Cale-star/shelter-beacon-demo/assets/img/07_wiring_inside.webp

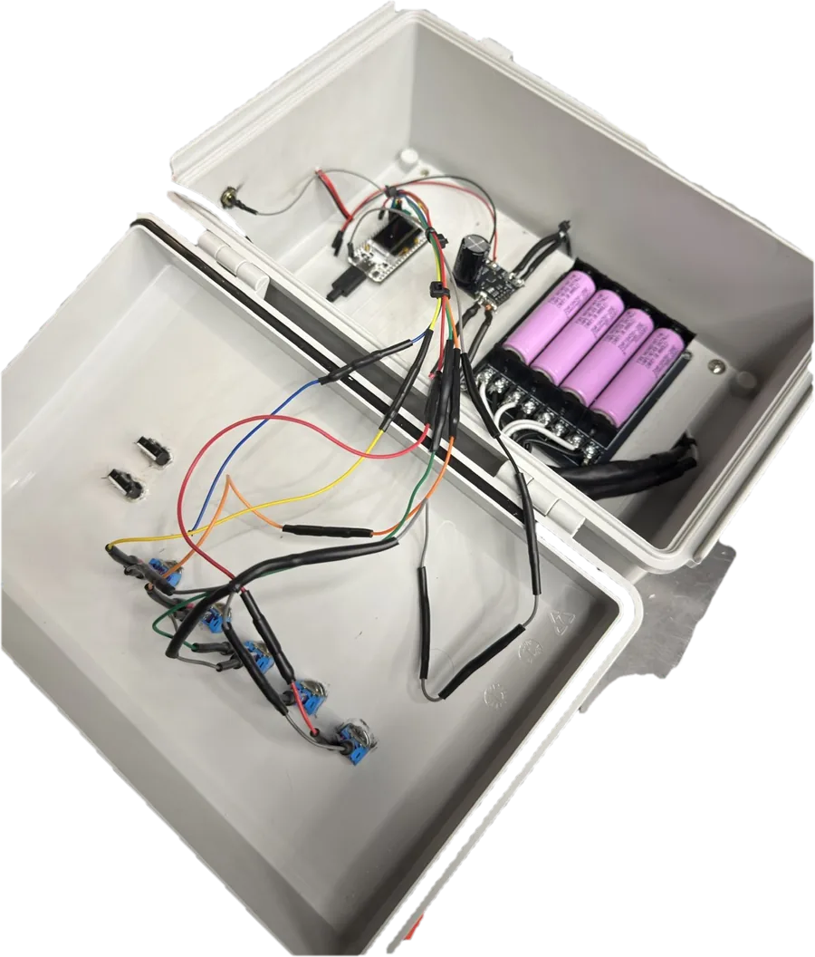
assets/img/07_wiring_inside.webp
