Cale-star/shelter-beacon-demo/assets/img/05_plate_in_box.webp

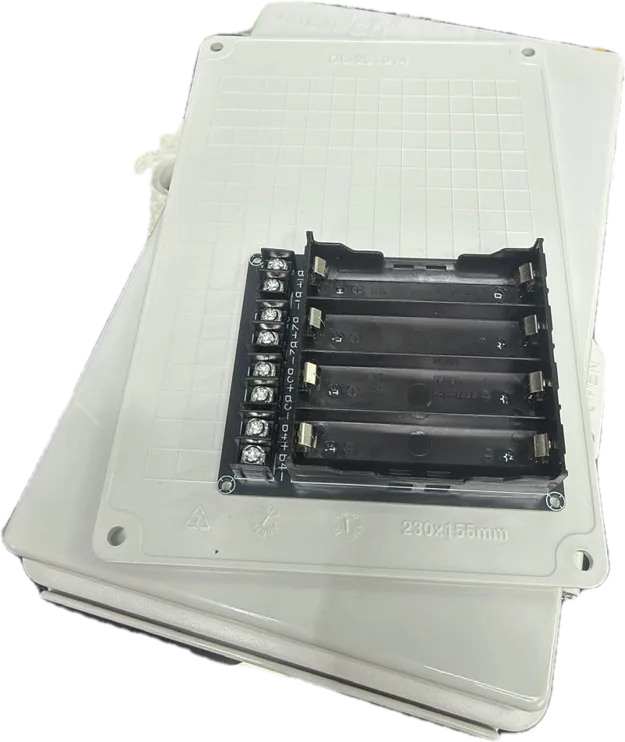
assets/img/05_plate_in_box.webp
