Cale-star/shelter-beacon-demo/assets/files/Shelter_Beacon_Lid_Template_and_Overlay.pdf

Shelter Beacon lid: DRILL TEMPLATE (page 1/2). Print on US Legal at 100% / Actual size, check the 100 mm ruler. Trim on the outline, tape to the lid (hinges on the LEFT), center-punch each crosshair, drill. Check the toggle hole size against your old box before drilling.

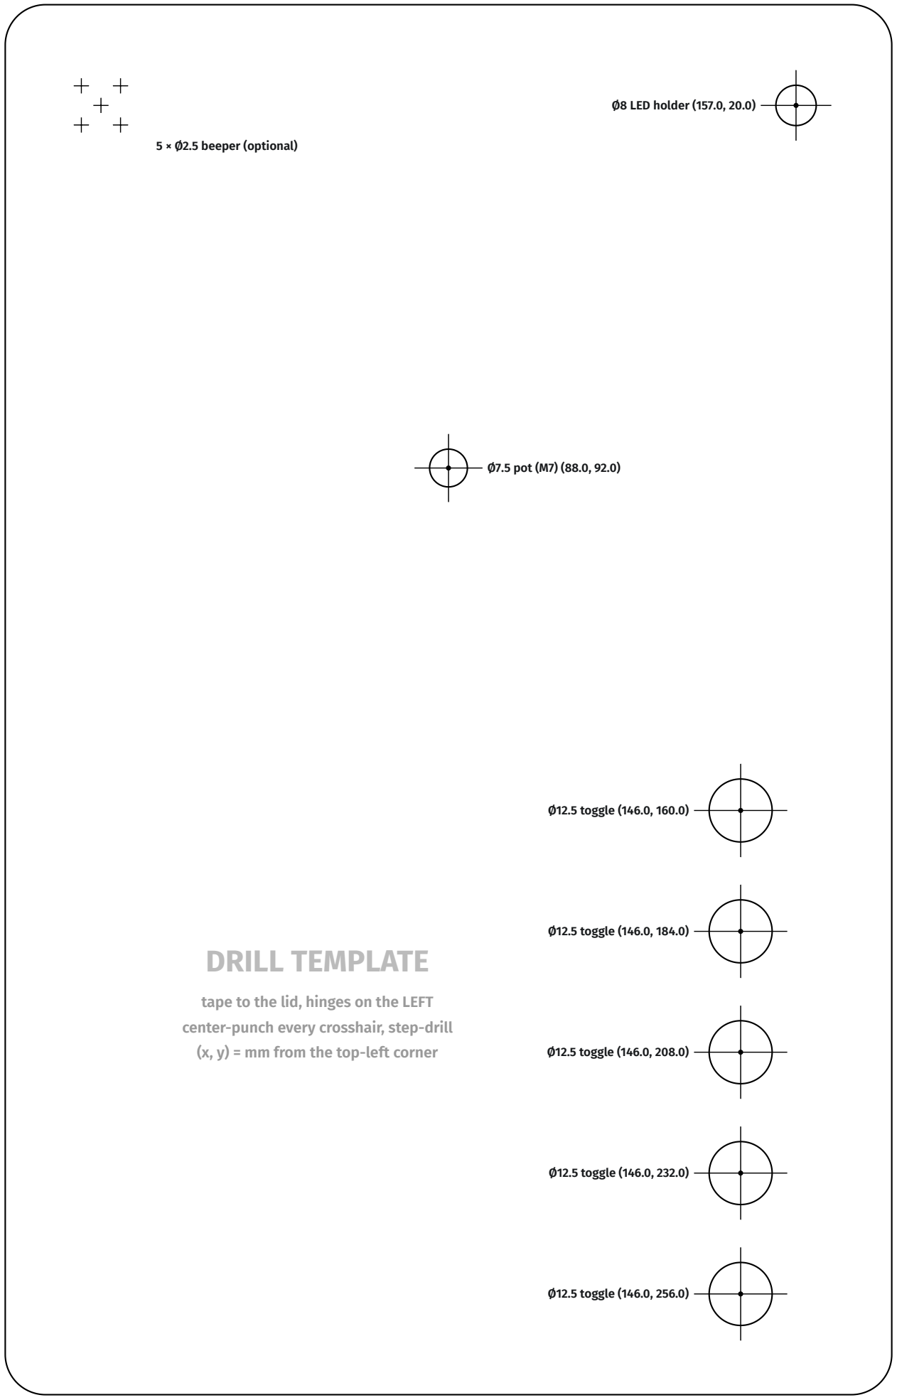
[picture p4: figure]
Ø8 LED holder (157.0, 20.0); Ø7.5 pot (M7) (88.0, 92.0); Ø12.5 toggle (146.0, 160.0); Ø12.5 toggle (146.0, 184.0); Ø12.5 toggle (146.0, 208.0); Ø12.5 toggle (146.0, 232.0); Ø12.5 toggle (146.0, 256.0); 5 × Ø2.5 beeper (optional); DRILL TEMPLATE; tape to the lid, hinges on the LEFT center-punch every crosshair, step-drill (x, y) = mm from the top-left corner

100 mm: measure this to check the print scale

Shelter Beacon lid: OVERLAY (page 2/2). Plain paper = test fit. Printable matte vinyl + matte laminate = the real thing. Cut on the red dashed outline, punch the dashed circles, apply AFTER drilling, then refit the nuts over it.

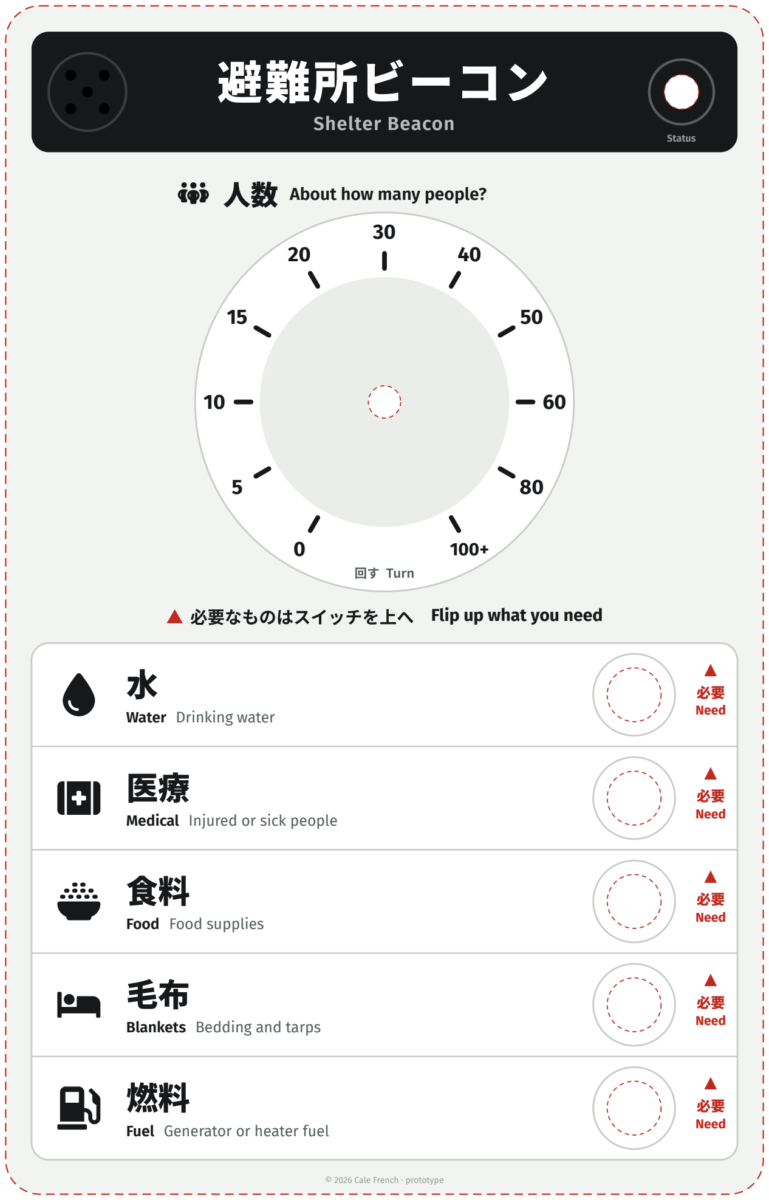
[picture p5: figure]
避難所ビーコン; Shelter Beacon; Status; 人数 About how many people?; 回す Turn; ▲ 必要なものはスイッチを上へ Flip up what you need; Water Drinking water; 必要 Need; Medical Injured or sick people; Food Food supplies; Blankets Bedding and tarps; Fuel Generator or heater fuel; © 2026 Cale French · prototype

100 mm: measure this to check the print scale
