Cale-star/shelter-beacon-demo/assets/img/01_lid_switch_layout.webp

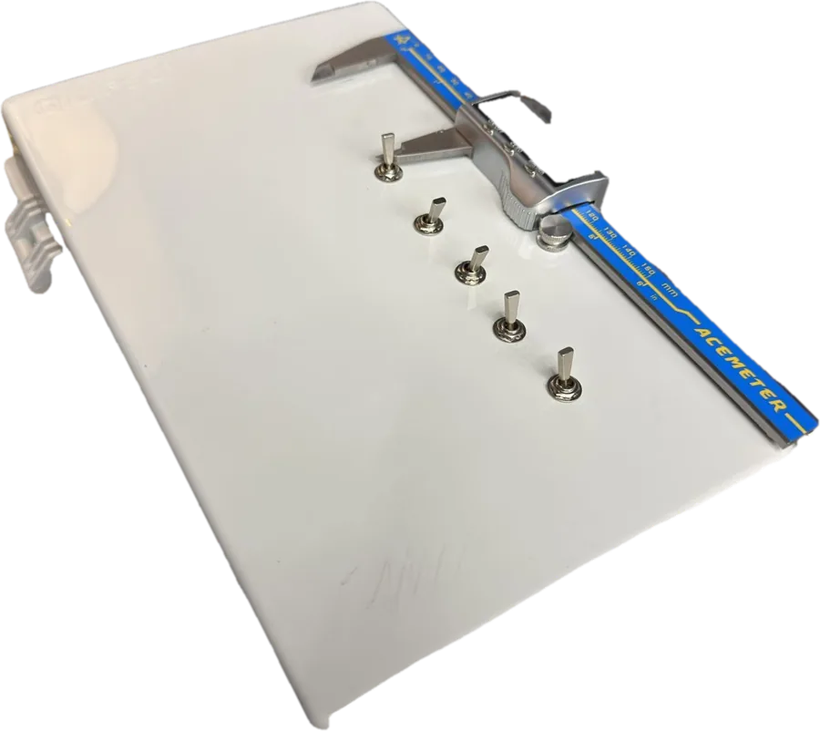
assets/img/01_lid_switch_layout.webp
