Cale-star/shelter-beacon-demo/assets/img/06_battery_mounted.webp

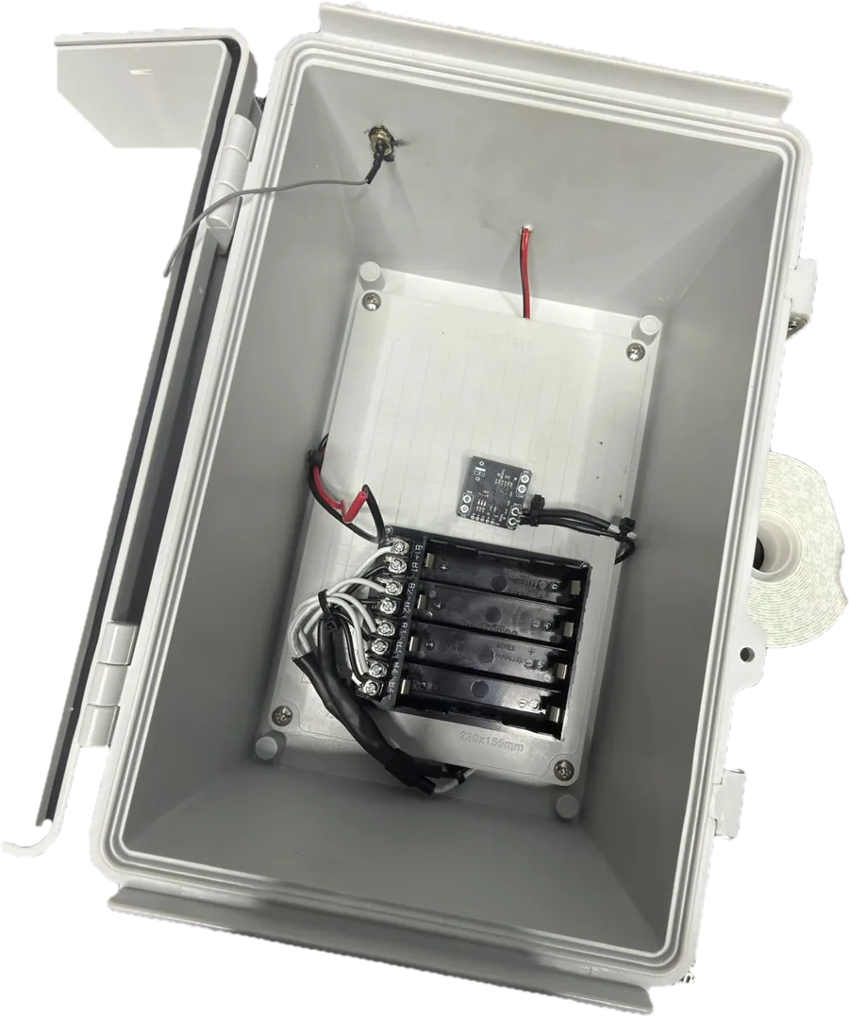
assets/img/06_battery_mounted.webp
