Cale-star/shelter-beacon-demo/assets/img/dashboard_2_needs_water.jpg

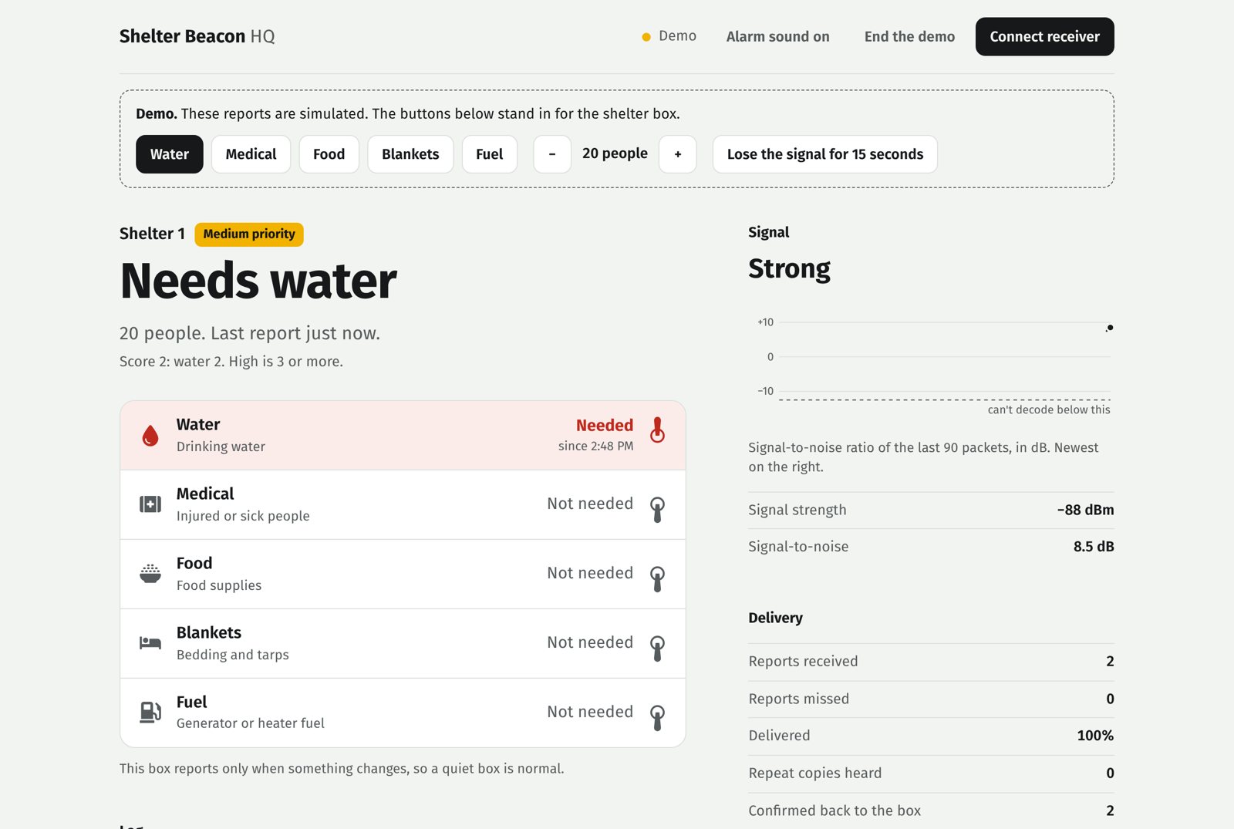
assets/img/dashboard_2_needs_water.jpg
