Cale-star/shelter-beacon-demo/assets/img/dashboard_3_high_priority_alarm.jpg

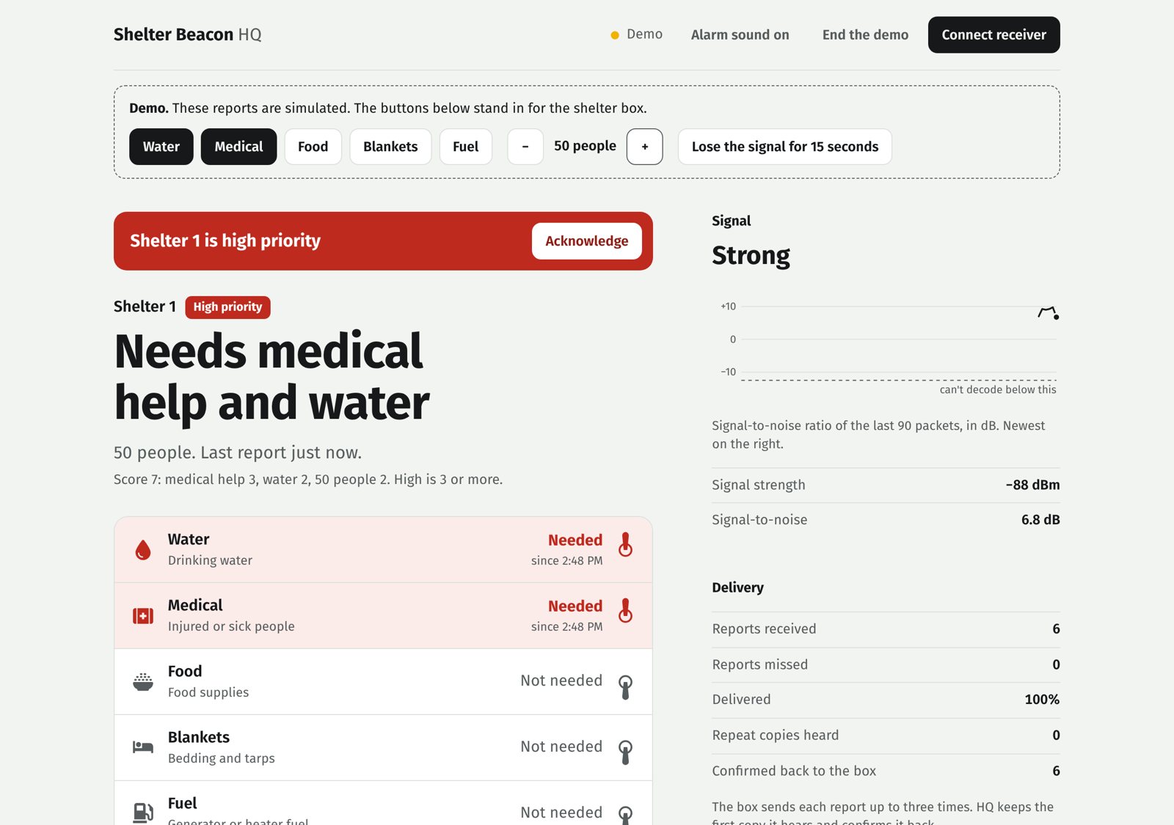
assets/img/dashboard_3_high_priority_alarm.jpg
