Cale-star/shelter-beacon-demo/assets/img/dashboard_4_dark_acknowledged.jpg

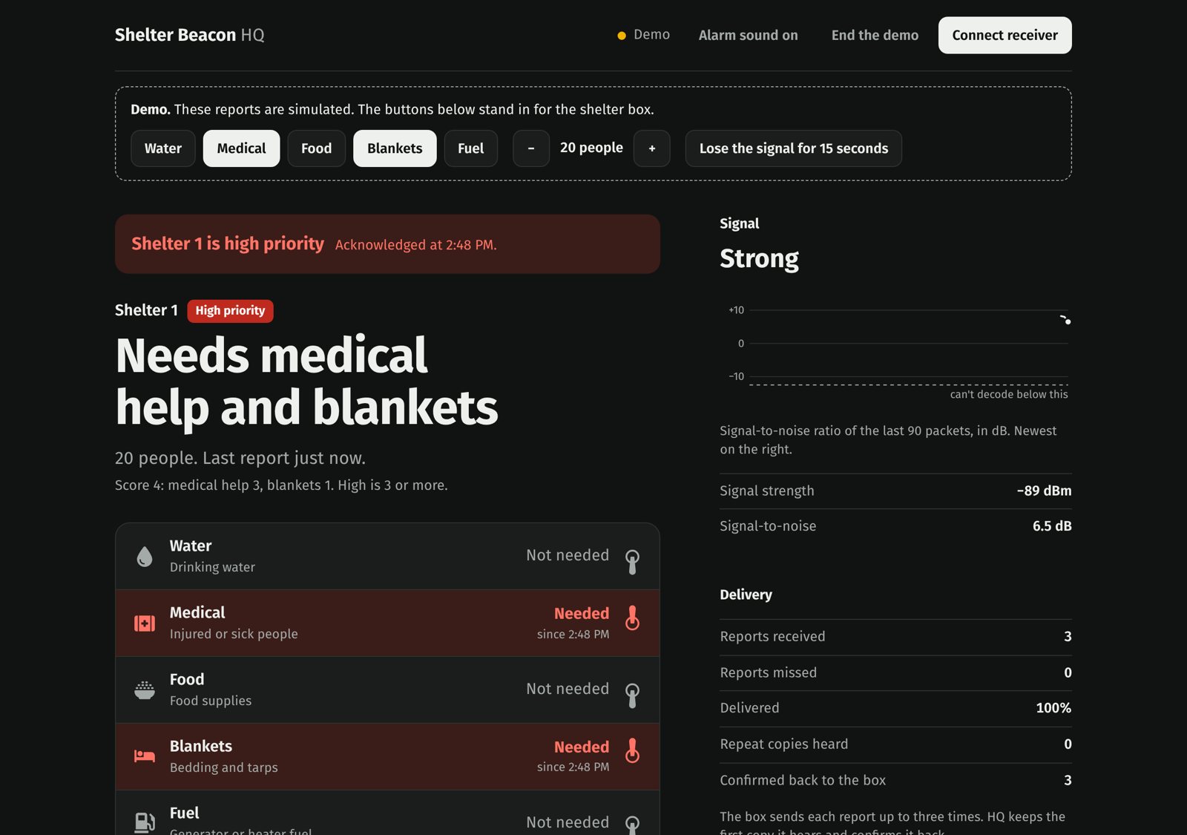
assets/img/dashboard_4_dark_acknowledged.jpg
