Cale-star/shelter-beacon-demo/assets/img/dashboard_crop.jpg

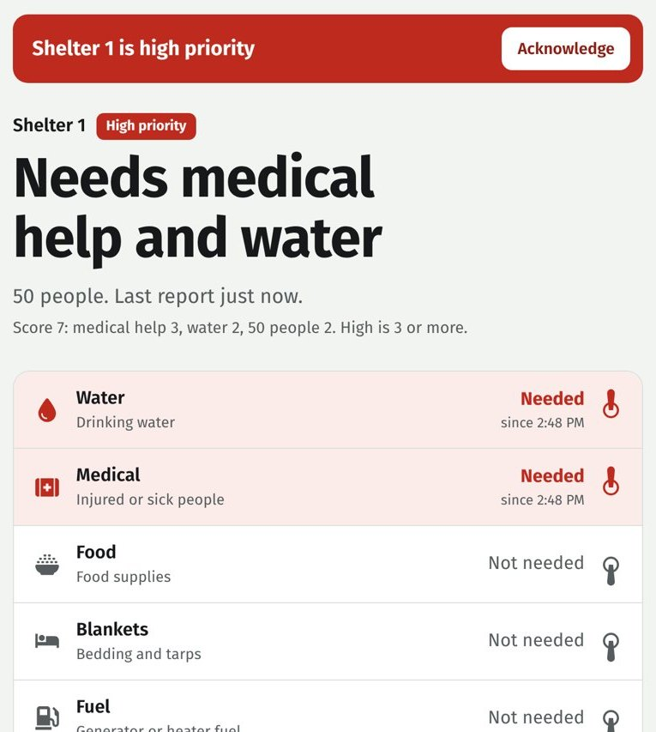
assets/img/dashboard_crop.jpg
