Cale-star/shelter-beacon-demo/assets/img/dashboard_phone.jpg

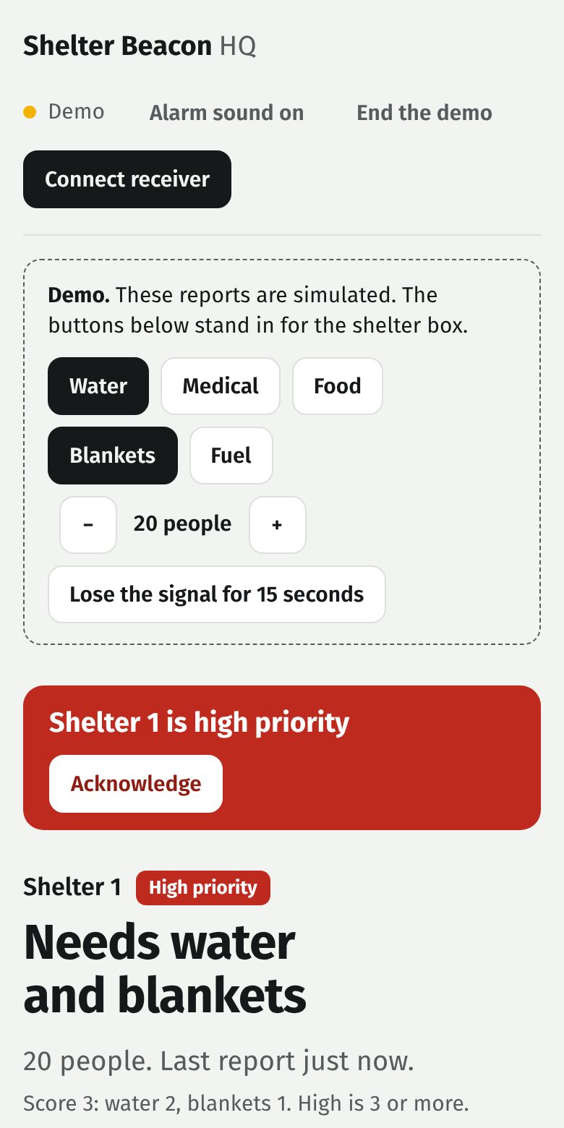
assets/img/dashboard_phone.jpg
