Cale-star/shelter-beacon-demo/assets/img/lid_overlay.webp

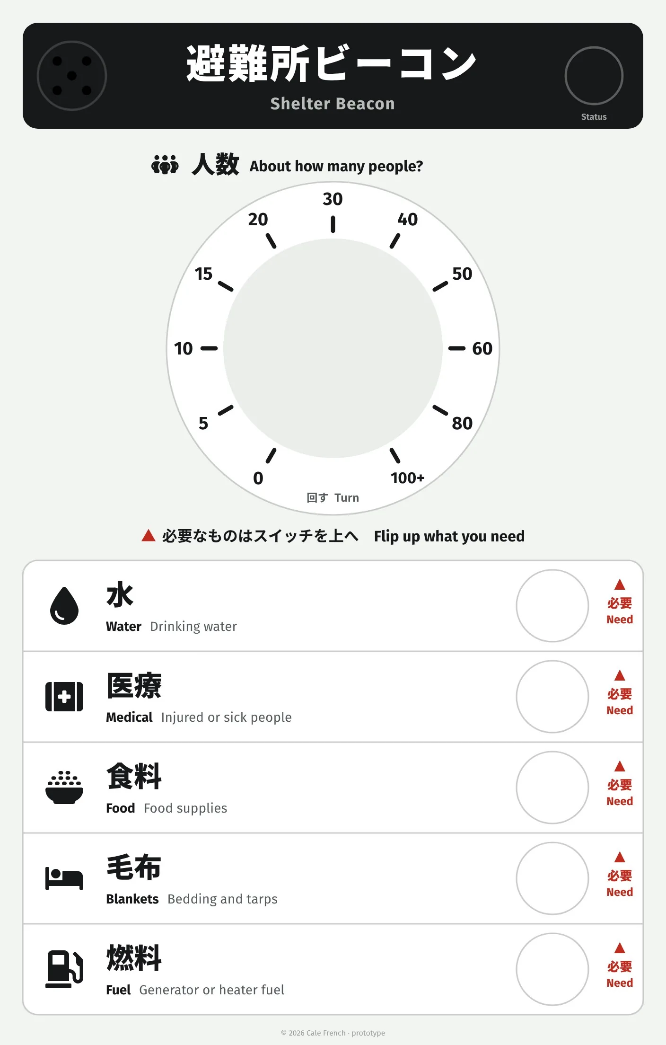
assets/img/lid_overlay.webp
