Cale-star/shelter-beacon-demo/assets/img/og.png

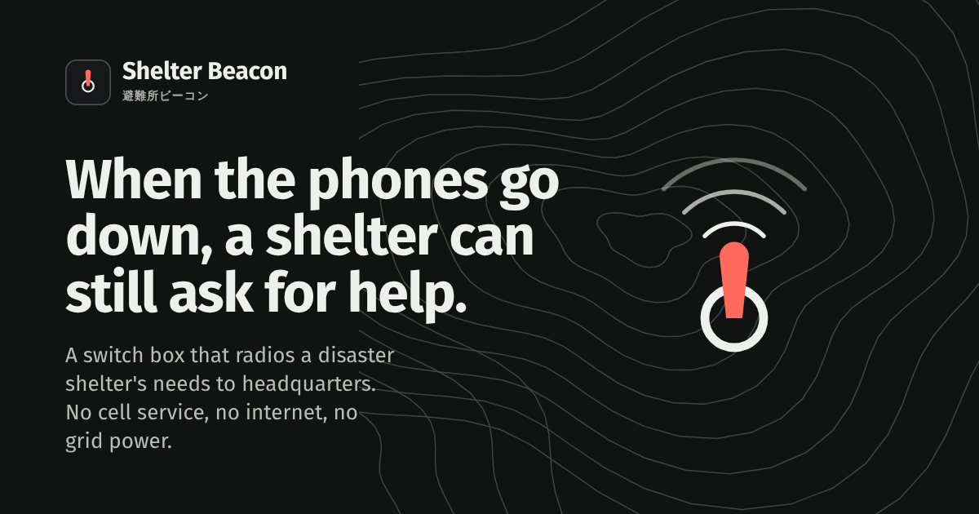
assets/img/og.png
