Cale-star/shelter-beacon-demo/assets/files/big_knob.stl

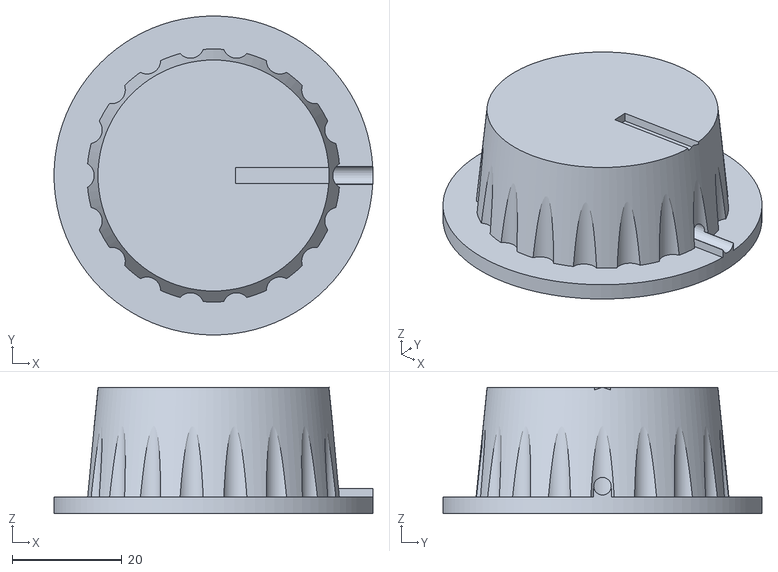
[picture p15: CAD file, 2026-11-13]
assets/files/big_knob.stl
58.0 x 58.0 x 23.0
