Cale-star/shelter-beacon-demo/assets/models/charger_cover.stl

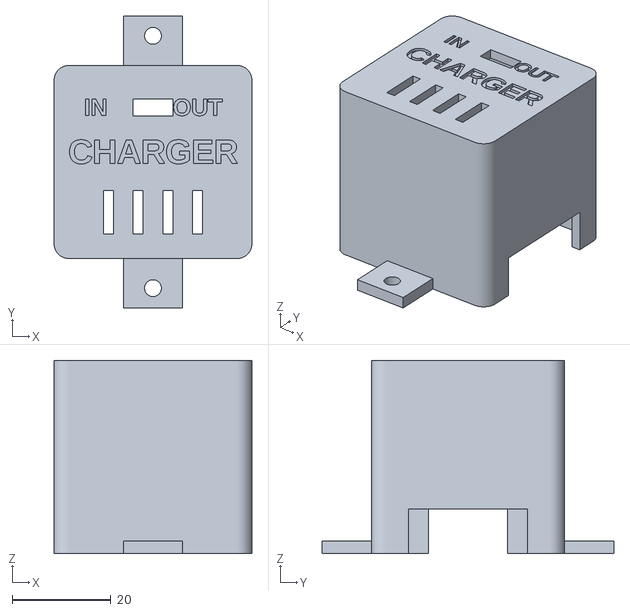
[picture p16: CAD file, 2026-11-13]
assets/models/charger_cover.stl
40.0 x 59.0 x 39.0
