Cale-star/shelter-beacon-demo/(list of files, cad)

Other CAD files:
assets/models/knob.stl
assets/files/charger_cover.stl
