Cale-star/shelter-beacon-demo/assets/files/Shelter_Beacon_Labels_and_Card.pdf

### Shelter Beacon: box face labels

Print at 100% / Actual size (no "fit to page"). Best on waterproof vinyl sticker paper, or plain paper covered with clear packing tape. Cut on the dashed lines.

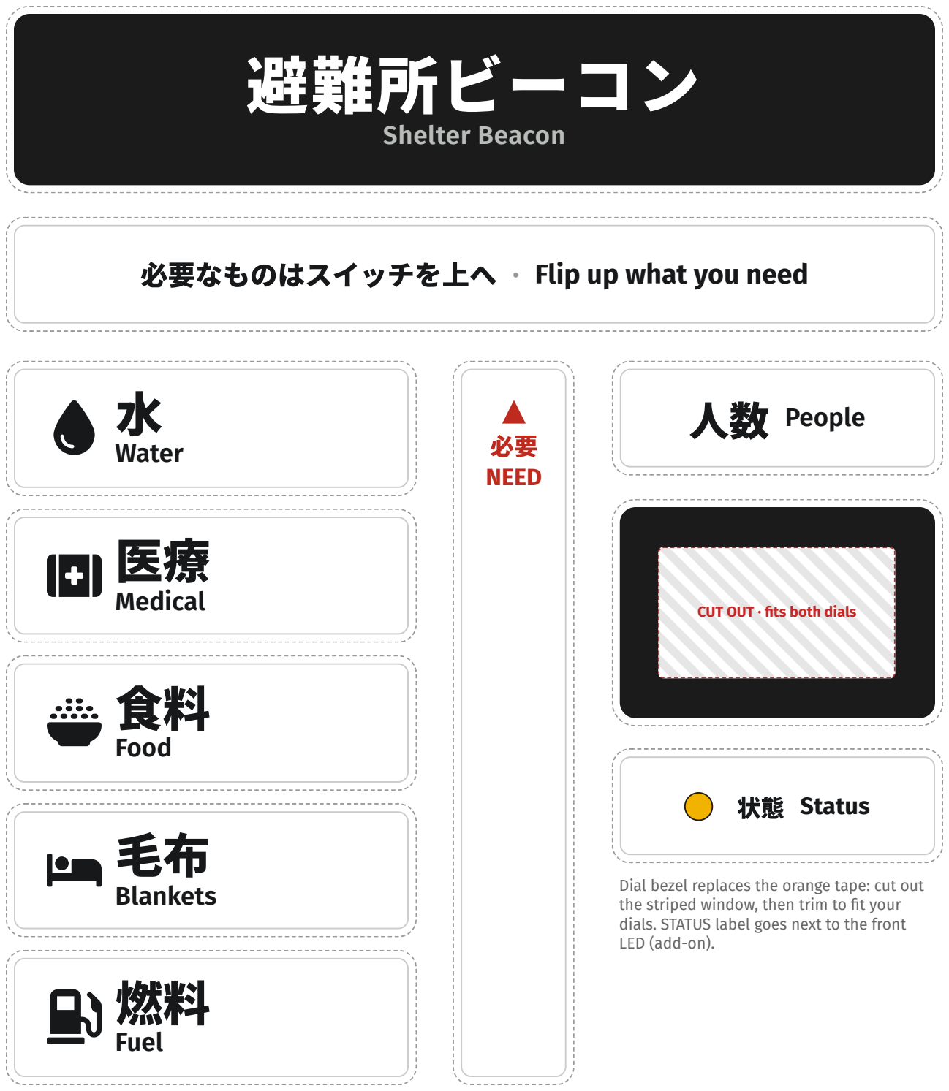
[picture p17: figure]
避難所ビーコン; Shelter Beacon; 必要なものはスイッチを上へ · Flip up what you need; Water; Medical; Food; Blankets; Fuel; 必要 NEED; 人数 People; CUT OUT · fits both dials; 状態 Status; LED (add-on).

Dial bezel replaces the orange tape: cut out the striped window, then trim to fit your dials. STATUS label goes next to the front

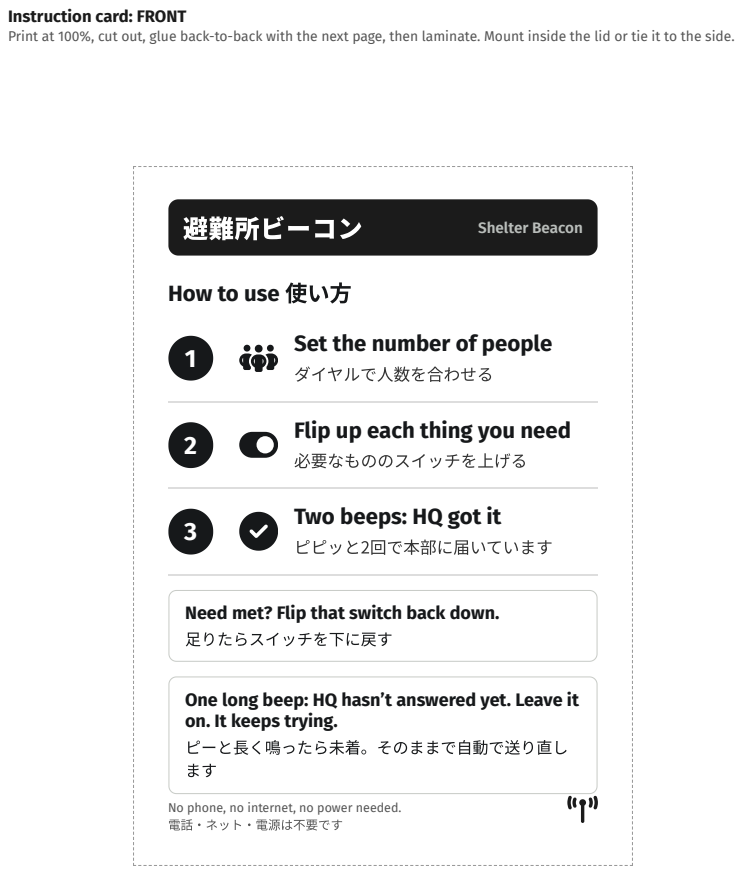
[picture p18: page 2]
避難所ビーコン; Shelter Beacon; ダイヤルで人数を合わせる; 必要なもののスイッチを上げる; ピピッと2回で本部に届いています; ネット・; 電源は不要です

Instruction card: FRONT
Print at 100%, cut out, glue back-to-back with the next page, then laminate. Mount inside the lid or tie it to the side.

How to use 使い方

Set the number of people

Flip up each thing you need

Two beeps: HQ got it

Need met? Flip that switch back down.
足りたらスイッチを下に戻す

One long beep: HQ hasn’t answered yet. Leave it
on. It keeps trying.
ピーと長く鳴ったら未着。そのままで自動で送り直し

No phone, no internet, no power needed.

Switch guide | スイッチの意味

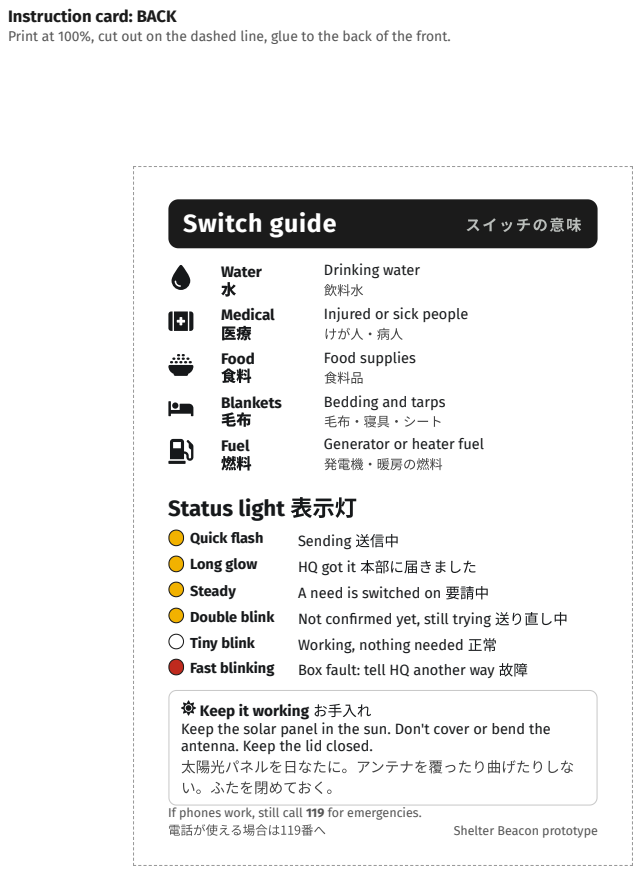
[picture p19: page 3]
Water 水 Medical 医療; けが人・; Food 食料 Blankets 毛布; シート; Fuel 燃料; 発電機・; 暖房の燃料; Status light 表示灯; Quick flash; Sending 送信中; Long glow; HQ got it 本部に届きました; Steady; A need is switched on 要請中; Double blink; Not confirmed yet, still trying 送り直し中; Tiny blink; Working, nothing needed 正常; Fast blinking; Box fault: tell HQ another way 故障; 電話が使える場合は119番へ; Shelter Beacon prototype

Instruction card: BACK
Print at 100%, cut out on the dashed line, glue to the back of the front.

Drinking water
飲料水
Injured or sick people
Food supplies
食料品
Bedding and tarps
Generator or heater fuel

Keep it working お手入れ
Keep the solar panel in the sun. Don't cover or bend the
antenna. Keep the lid closed.
太陽光パネルを日なたに。アンテナを覆ったり曲げたりしな
い。ふたを閉めておく。
If phones work, still call 119 for emergencies.

15

20

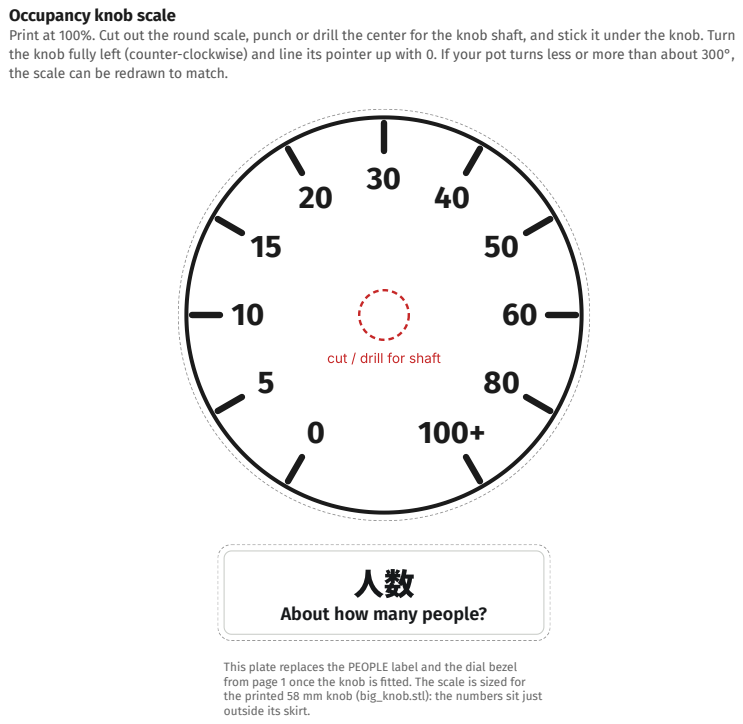
[picture p20: page 4]

Occupancy knob scale
Print at 100%. Cut out the round scale, punch or drill the center for the knob shaft, and stick it under the knob. Turn
the knob fully left (counter-clockwise) and line its pointer up with 0. If your pot turns less or more than about 300°,
the scale can be redrawn to match.

cut / drill for shaft

About how many people?

This plate replaces the PEOPLE label and the dial bezel
from page 1 once the knob is fitted. The scale is sized for
the printed 58 mm knob (big_knob.stl): the numbers sit just
outside its skirt.
