Cale-star/shelter-beacon-demo/assets/files/Shelter_Beacon_Lid_Overlay_SIGNSHOP.pdf

# 避難所ビーコン

### Shelter Beacon

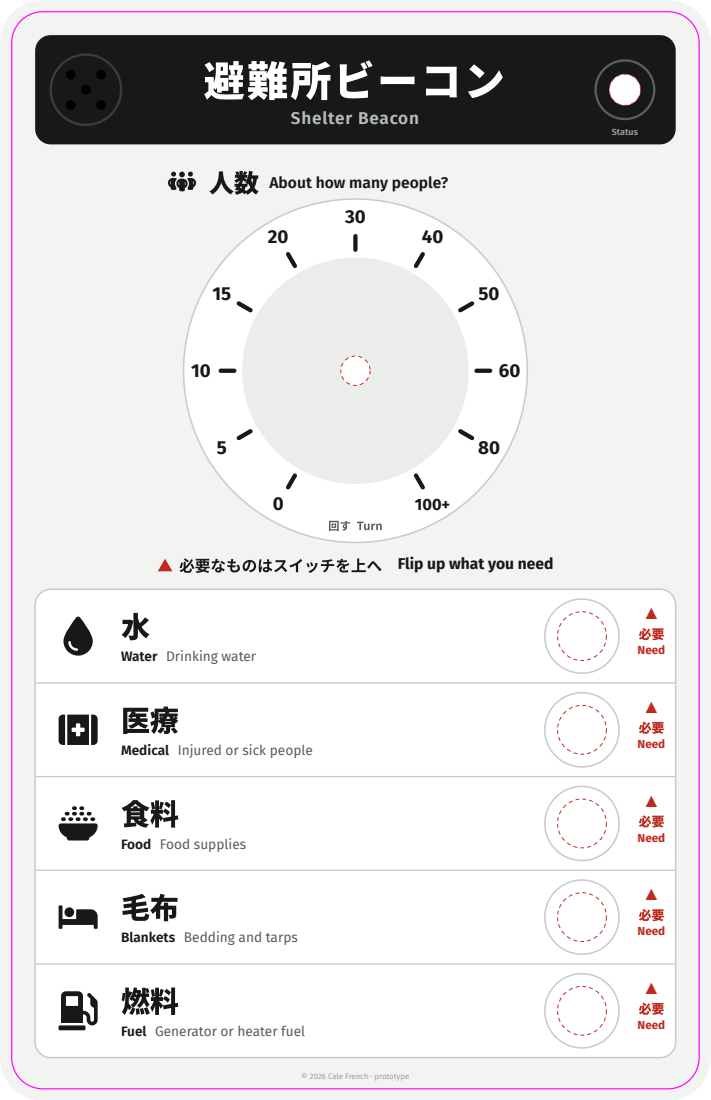
[picture p21: page 1]
Status; 回す Turn; 必要 Need

人数 About how many people?

▲ 必要なものはスイッチを上へ Flip up what you need

Water Drinking water

Medical Injured or sick people

Food Food supplies

Blankets Bedding and tarps

Fuel Generator or heater fuel

© 2026 Cale French · prototype
