Cale-star/shelter-beacon-demo/(commit log)

2026-11-06 Demo box redesigned to match the real enclosure
    Antenna top-left, hinges and latches, title plate, 2-digit thumbwheel,
    five bat-handle toggles (up = need), bilingual labels, status light.
    Claude-Session: https://claude.ai/code/session_014XA1GBdRkz1fNkNYGeD8bD
2026-11-06 Declutter the demo box face
    One cue per job: switch position + subtle outline for state, a single
    "NEED" header over the switches, status light in the title plate, quiet
    resend button; removed the legend strip, state text and serial line.
    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
2026-11-06 Center the people dial, remove the resend button
    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
2026-11-06 Demo: click-knob for people (0-100+ uneven scale), snappier toggle animation
    Knob: drag, tap a number, +/- buttons or arrow keys; spring detent animation;
    sends after the knob settles, like the v0.5 firmware.
    Toggles: overshoot snap, moving shadow, nut press, haptic tick on Android.
    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
2026-11-13 Preview: calculators, beeps, Build one, spec sheet, expo mode
    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
    [big_knob.stl, charger_cover.stl]
2026-11-13 Preview: interactive 3D box, cut-away, animated graphics, spacing fixes
    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
2026-11-13 Preview: slower cut-away with controls
    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
2026-11-13 Preview: more realistic 3D model
    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
    [charger_cover.stl, knob.stl]
